naokiiwakami/cv-depot/doc/schematic-0.png

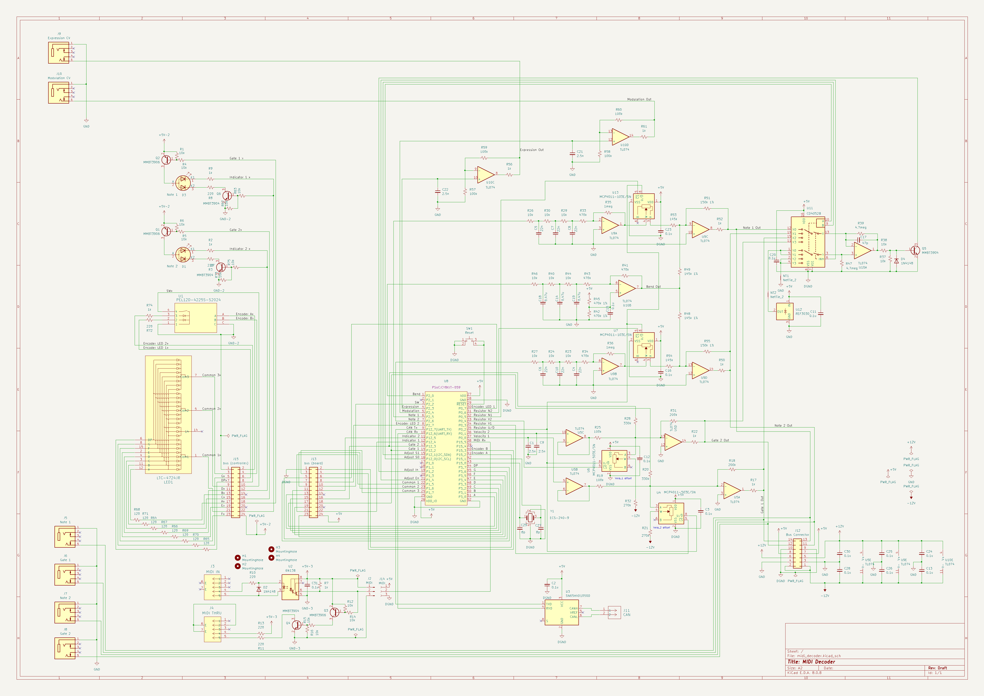
doc/schematic-0.png
