naokiiwakami/cv-depot/doc/schematic-1.png

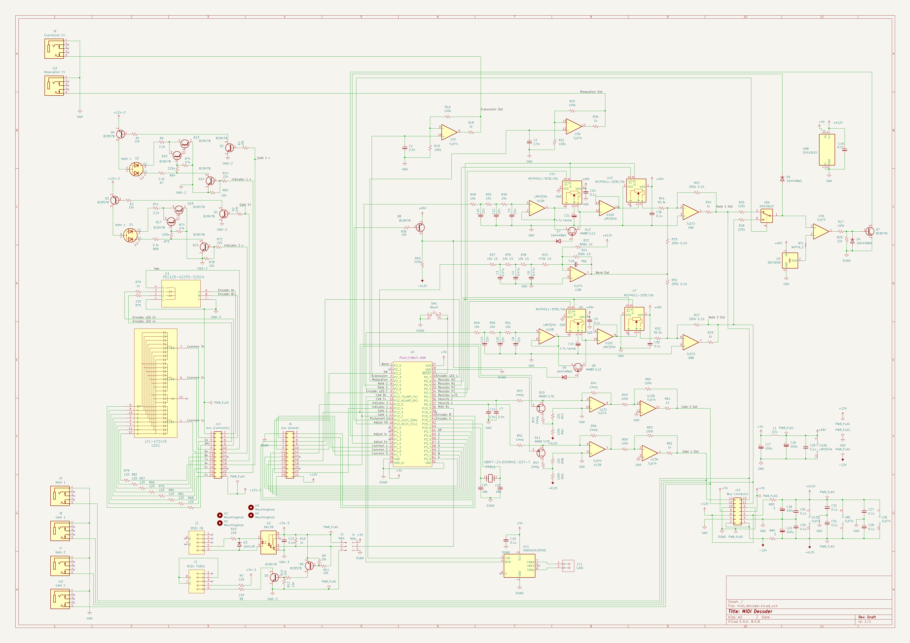
doc/schematic-1.png
