naokiiwakami/cv-depot/simulations/anti-alias-filter.asc

C1: cap; .0022µ
C2: cap; .0022µ
C3: cap; 2.2µ
R1: res; 1Meg
R2: res; 420k
R3: res; 10k
R4: res; 10k
R5: res; 70
R6: res; 49.03k
U1: TL072
V1: voltage; 12
V2: voltage; 12
V3: voltage; PULSE(0 5 10m 1n 1n 3u 5u 2000)
Named nets: 0
.tran 100m
