naokiiwakami/cv-depot/simulations/pi-filter-for-power-supply.asc

C1: cap; 100µ
C2: cap; 100µ
L1: ind; 22µ; Rser=1.25
R1: res; 4.7k
V1: voltage; ""; AC 1 0
Named nets: 0
.ac dec 100 1 200k
