naokiiwakami/cv-depot/simulations/rc-filter-for-power-supply.asc

C2: cap; 100µ; Rser=27m
R1: res; 5
V1: voltage; ""; AC 1 0
Named nets: 0
.ac dec 100 1 20k
