naokiiwakami/cv-depot/kicad/cv-depot.kicad_pcb

## KiCad design kicad/cv-depot.kicad_pcb (2025-03-31)

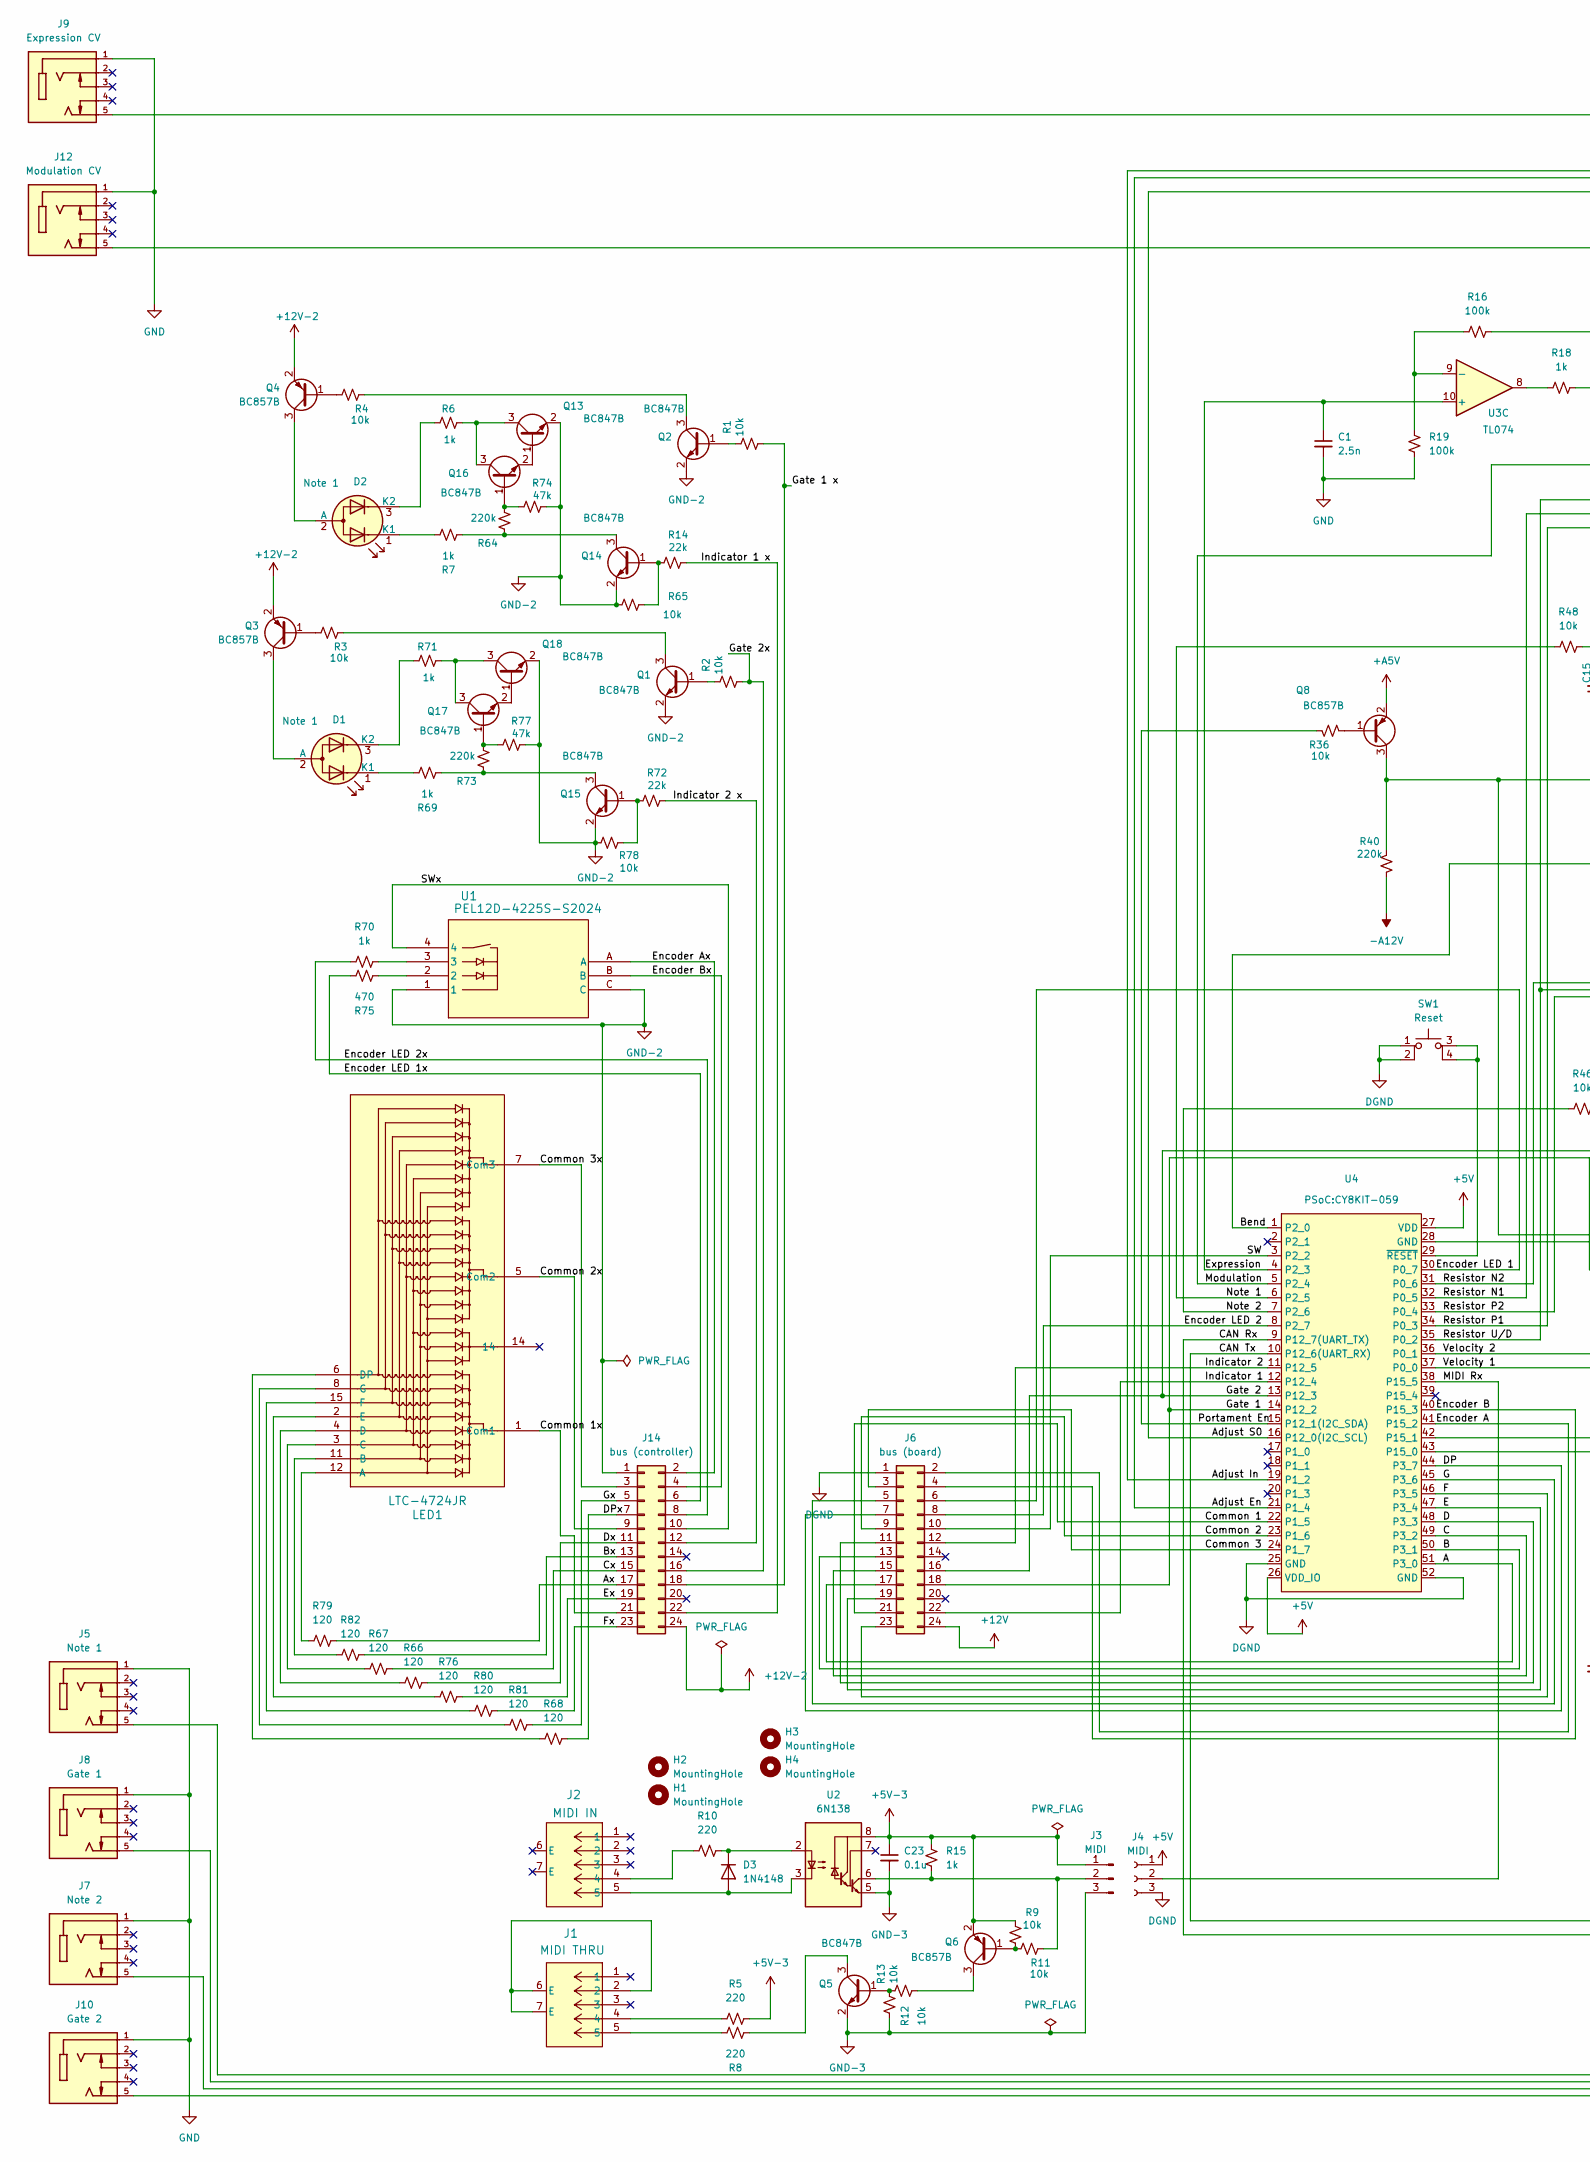
[picture p3: schematic cv-depot.kicad_sch, MIDI Decoder, part in row 1, column 1]

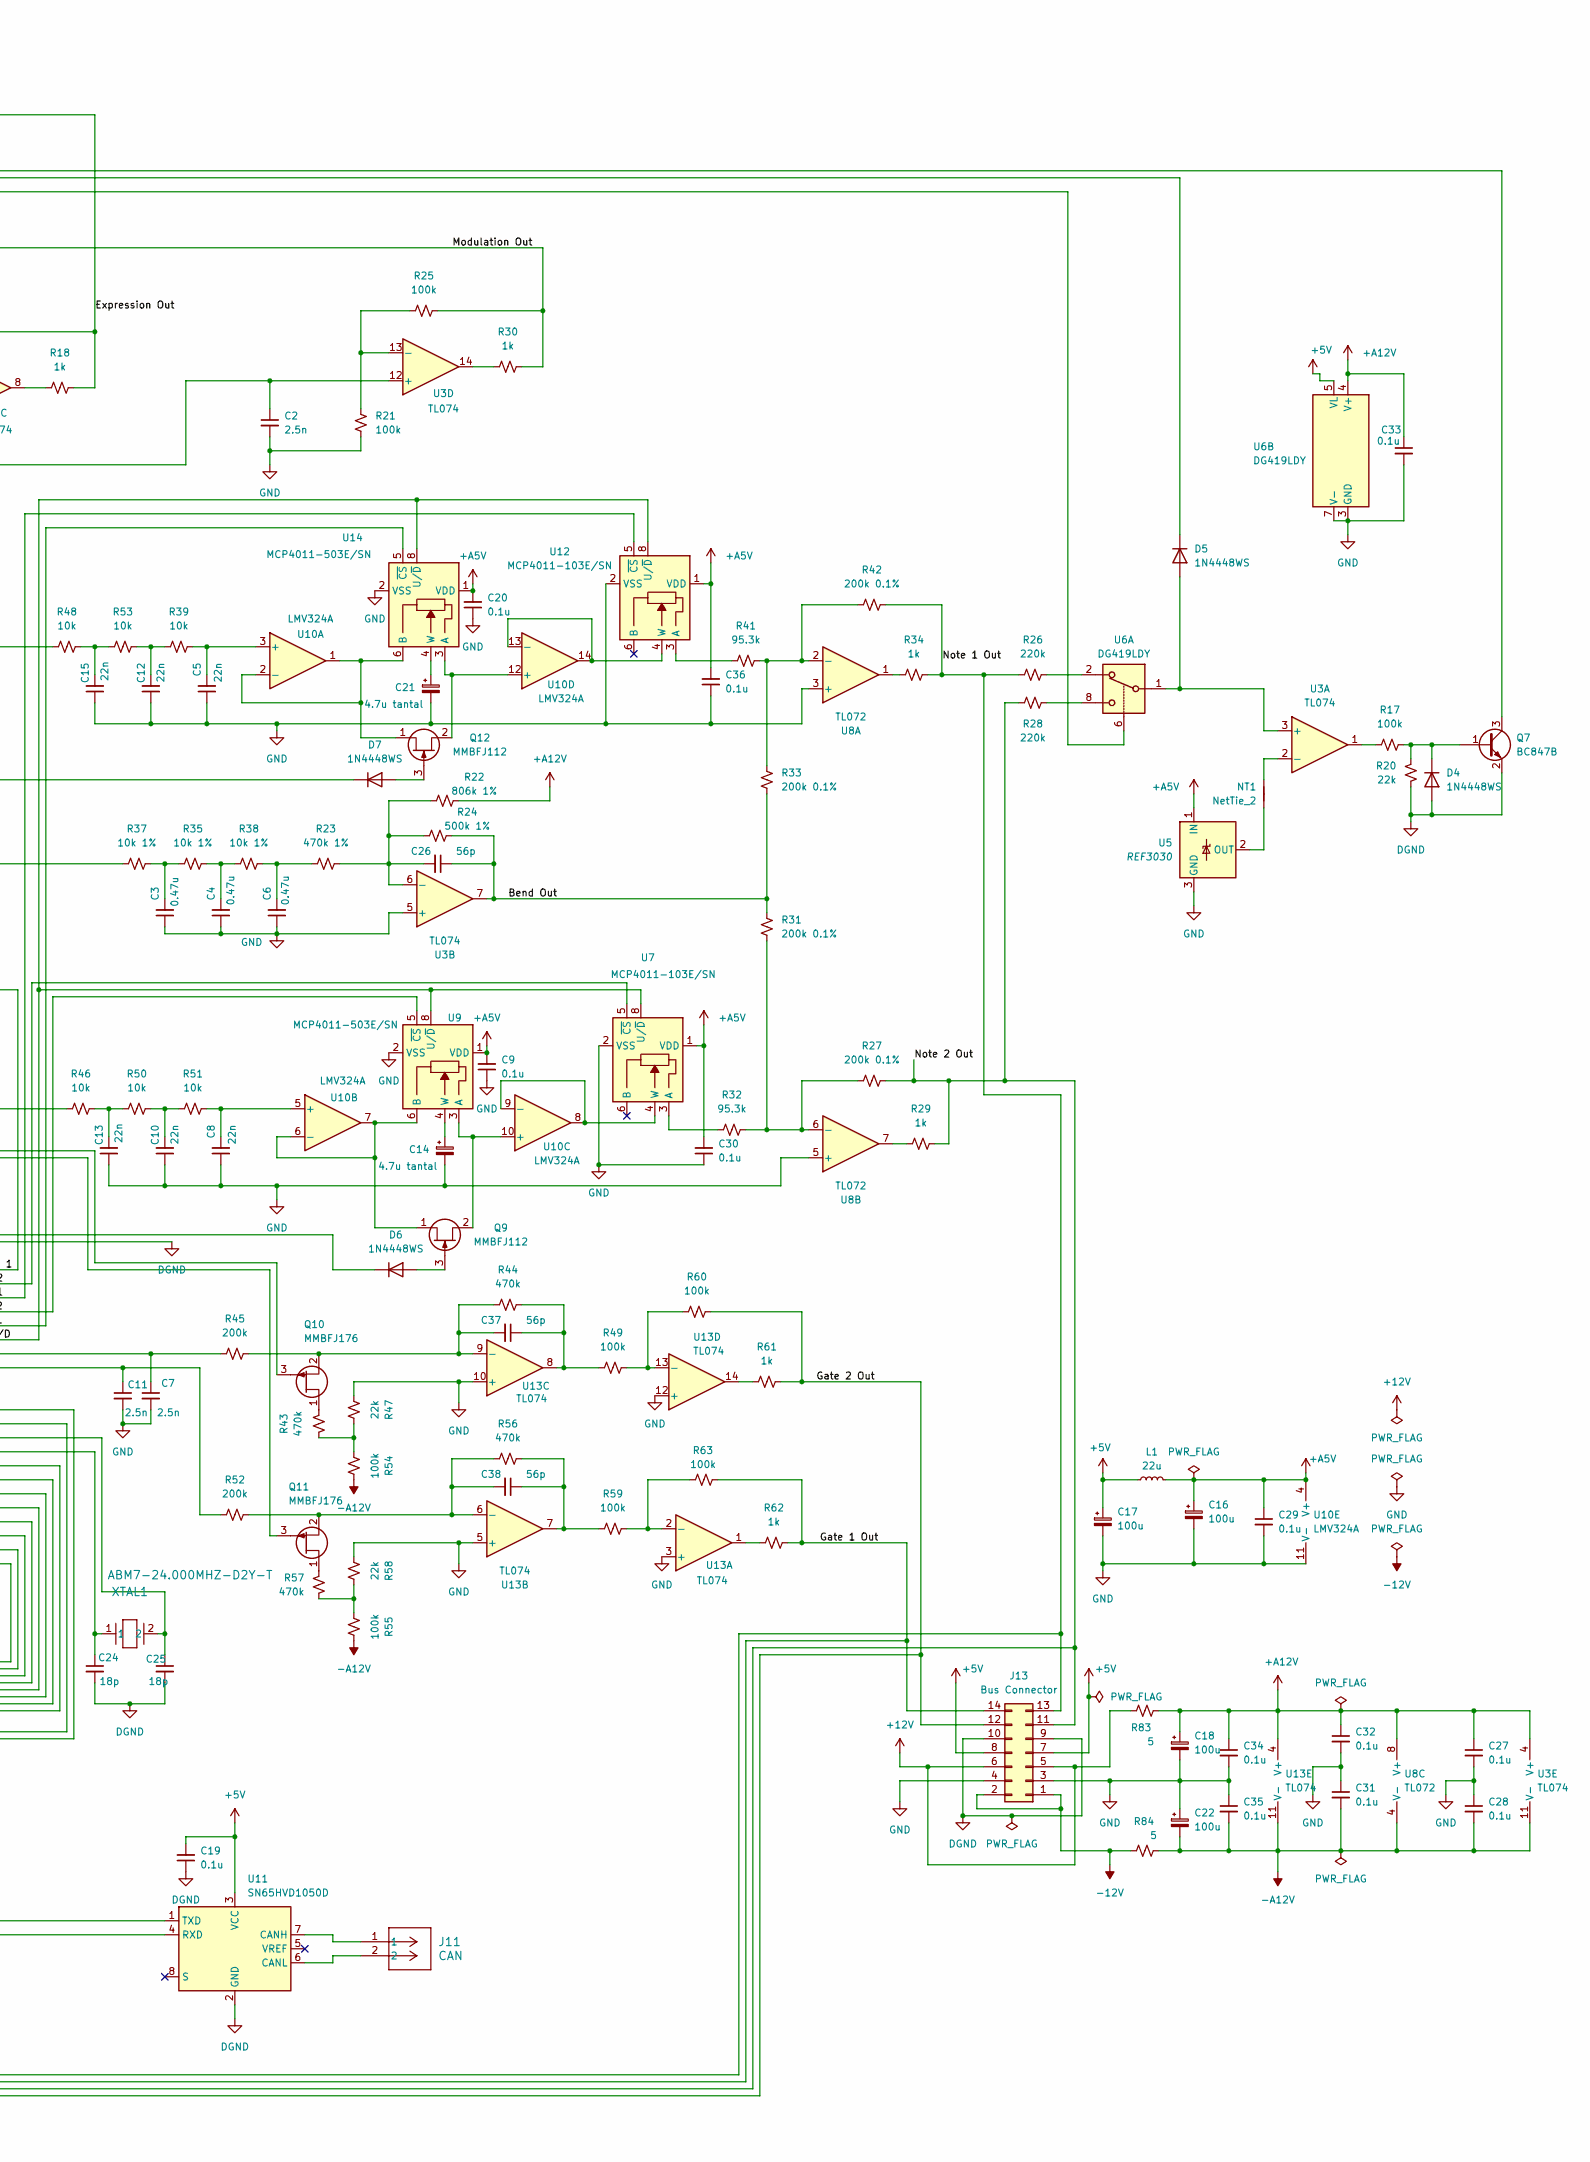
[picture p4: schematic cv-depot.kicad_sch, MIDI Decoder, part in row 1, column 2]

Parts:
C1, C2, C7, C11: 2.5n; C_0805_2012Metric_Pad1.18x1.45mm_HandSolder
C3, C4, C6: 0.47u; C_0805_2012Metric_Pad1.18x1.45mm_HandSolder
C5, C8, C10, C12, C13, C15: 22n; C_0805_2012Metric_Pad1.18x1.45mm_HandSolder
C9, C19, C20, C27, C28, C29, C30, C31, C32, C33, C34, C35, C36: 0.1u; C_0805_2012Metric_Pad1.18x1.45mm_HandSolder
C14, C21: 4.7u tantal; CP_EIA-3216-10_Kemet-I_Pad1.58x1.35mm_HandSolder
C16, C17: 100u; CP_Elec_5x5.3
C18, C22: 100u; CP_Radial_D6.3mm_P2.50mm
C23: 0.1u; R_0805_2012Metric_Pad1.20x1.40mm_HandSolder
C24, C25: 18p; C_0805_2012Metric_Pad1.18x1.45mm_HandSolder
C26, C37, C38: 56p; C_0805_2012Metric_Pad1.18x1.45mm_HandSolder
D1, D2: Note 1; LED_D5.0mm-3
D3: 1N4148; D_DO-35_SOD27_P7.62mm_Horizontal
D4, D5, D6, D7: 1N4448WS; D_SOD-323_HandSoldering
H1, H2, H3, H4: MountingHole; MountingHole_3.2mm_M3
J1: MIDI THRU; CONN5_SDS-50J_CUD
J2: MIDI IN; CONN5_SDS-50J_CUD
J3: MIDI; PinHeader_1x03_P2.54mm_Vertical
J4: MIDI; PinSocket_1x03_P2.54mm_Vertical
J5: Note 1; CONN_35RAPC4BH3_SWC; PARTREV J
J6: bus (board); PinHeader_2x12_P2.54mm_Vertical
J7: Note 2; CONN_35RAPC4BH3_SWC; PARTREV J
J8: Gate 1; CONN_35RAPC4BH3_SWC; PARTREV J
J9: Expression CV; CONN_35RAPC4BH3_SWC; PARTREV J
J10: Gate 2; CONN_35RAPC4BH3_SWC; PARTREV J
J11: CAN; CONN_A-6373-02A_MOL
J12: Modulation CV; CONN_35RAPC4BH3_SWC; PARTREV J
J13: Bus Connector; IDC-Header_2x07_P2.54mm_Vertical
J14: bus (controller); PinHeader_2x12_P2.54mm_Vertical
L1: 22u; L_0805_2012Metric_Pad1.05x1.20mm_HandSolder
LED1: LTC-4724JR; LTC-4724JR_LTO
NT1: NetTie_2; NetTie-2_SMD_Pad0.5mm
Q1, Q2, Q5, Q7, Q13, Q14, Q15, Q16, Q17, Q18: BC847B; SOT-23
Q3, Q4, Q6, Q8: BC857B; SOT-23
Q9, Q12: MMBFJ112; SOT-23
Q10, Q11: MMBFJ176; SOT-23
R1, R2, R3, R4, R9, R11, R12, R13, R36, R39, R46, R48, R50, R51, R53, R65, R78: 10k; D_0805_2012Metric_Pad1.15x1.40mm_HandSolder
R5, R8, R10: 220; R_0805_2012Metric_Pad1.20x1.40mm_HandSolder
R6, R7, R18, R29, R30, R34, R61, R62, R69, R70, R71: 1k; D_0805_2012Metric_Pad1.15x1.40mm_HandSolder
R14, R20, R72: 22k; D_0805_2012Metric_Pad1.15x1.40mm_HandSolder
R15: 1k; R_0805_2012Metric_Pad1.20x1.40mm_HandSolder
R16, R17, R19, R21, R25: 100k; D_0805_2012Metric_Pad1.15x1.40mm_HandSolder
R22: 806k 1%; D_0805_2012Metric_Pad1.15x1.40mm_HandSolder
R23: 470k 1%; D_0805_2012Metric_Pad1.15x1.40mm_HandSolder
R24: 500k 1%; D_0805_2012Metric_Pad1.15x1.40mm_HandSolder
R26, R28, R40, R64, R73: 220k; D_0805_2012Metric_Pad1.15x1.40mm_HandSolder
R27, R31, R33: 200k 0.1%; R_0805_2012Metric_Pad1.20x1.40mm_HandSolder
R32, R41: 95.3k; R_0805_2012Metric_Pad1.20x1.40mm_HandSolder
R35, R37, R38: 10k 1%; D_0805_2012Metric_Pad1.15x1.40mm_HandSolder
R42: 200k 0.1%; D_0805_2012Metric_Pad1.15x1.40mm_HandSolder
R43, R44, R56, R57: 470k; R_0805_2012Metric_Pad1.20x1.40mm_HandSolder
R45, R52: 200k; R_0805_2012Metric_Pad1.20x1.40mm_HandSolder
R47, R58: 22k; R_0805_2012Metric_Pad1.20x1.40mm_HandSolder
R49, R54, R55, R59, R60, R63: 100k; R_0805_2012Metric_Pad1.20x1.40mm_HandSolder
R66, R67, R68, R76, R79, R80, R81, R82: 120; R_0805_2012Metric_Pad1.20x1.40mm_HandSolder
R74, R77: 47k; D_0805_2012Metric_Pad1.15x1.40mm_HandSolder
R75: 470; D_0805_2012Metric_Pad1.15x1.40mm_HandSolder
R83, R84: 5; R_0805_2012Metric_Pad1.20x1.40mm_HandSolder
SW1: Reset; SW4_1825910-B_TEC
U1: PEL12D-4225S-S2024; TO_4225S-S2024
U2: 6N138; DIP-8_W7.62mm_LongPads
U3, U13: TL074; SOIC-14_3.9x8.7mm_P1.27mm
U4: CY8KIT-059
U5: REF3030; SOT-23
U6: DG419LDY; SOIC-8_3.9x4.9mm_P1.27mm
U7, U12: MCP4011-103E/SN; SOIC-8_3.9x4.9mm_P1.27mm
U8: TL072; SOIC-8_3.9x4.9mm_P1.27mm
U9, U14: MCP4011-503E/SN; SOIC-8_3.9x4.9mm_P1.27mm
U10: LMV324A; SOIC-14_3.9x8.7mm_P1.27mm
U11: SN65HVD1050D; SOIC-8_3.9x4.9mm_P1.27mm
XTAL1: ABM7-24.000MHZ-D2Y-T; XTAL_ABM7_ABR_handsoldering

Connections:
+5V: C17.1, C19.2, J4.1, J13.7, J13.8, L1.1, U4.26 (VDD_IO), U4.27 (VDD), U6.5 (VL), U11.3 (VCC)
+5V-3: C23.1, J3.1, Q6.2 (E), R5.2, R9.2, R15.2, U2.8 (VCC)
+12V: J6.24, J13.5, J13.6, R83.1
+12V-2: J14.24, Q3.2 (E), Q4.2 (E)
+A5V: C9.2, C16.1, C20.2, C29.1, C30.2, C36.2, L1.2, Q8.2 (E), U5.1 (IN), U7.1 (VDD), U9.1 (VDD), U10.4 (V+), U12.1 (VDD), U14.1 (VDD)
+A12V: C18.1, C27.1, C32.1, C33.1, C34.1, R22.2, R83.2, U3.4 (V+), U6.4 (V+), U8.8 (V+), U13.4 (V+)
-12V: J13.1, J13.2, R84.1
-A12V: C22.2, C28.2, C31.2, C35.2, R40.1, R54.2, R55.2, R84.2, U3.11 (V-), U8.4 (V-), U13.11 (V-)
/A: J6.17, U4.51 (P3_0)
/Adjust En: D5.1 (K), U4.21 (P1_4)
/Adjust In: Q7.3 (C), U4.19 (P1_2)
/Adjust S0: U4.16 (P12_0(I2C_SCL)), U6.6
/Ax: J14.17, R79.2
/B: J6.13, U4.50 (P3_1)
/Bend: R37.1, U4.1 (P2_0)
/Bend Out: C26.1, R24.2, R31.2, R33.1, U3.7
/Bx: J14.13, R82.2
/C: J6.15, U4.49 (P3_2)
/CAN Rx: U4.9 (P12_7(UART_TX)), U11.4 (RXD)
/CAN Tx: U4.10 (P12_6(UART_RX)), U11.1 (TXD)
/Common 1: J6.21, U4.22 (P1_5)
/Common 1x: J14.21, LED1.1 (Com1)
/Common 2: J6.9, U4.23 (P1_6)
/Common 2x: J14.9, LED1.5 (Com2)
/Common 3: J6.3, U4.24 (P1_7)
/Common 3x: J14.3, LED1.7 (Com3)
/Cx: J14.15, R67.2
/D: J6.11, U4.48 (P3_3)
/DP: J6.7, U4.44 (P3_7)
/DPx: J14.7, R68.2
/Dx: J14.11, R66.2
/E: J6.19, U4.47 (P3_4)
/Encoder A: J6.2, U4.41 (P15_2)
/Encoder Ax: J14.2, U1.A
/Encoder B: J6.4, U4.40 (P15_3)
/Encoder Bx: J14.4, U1.B
/Encoder LED 1: J6.6, U4.30 (P0_7)
/Encoder LED 1x: J14.6, R75.2
/Encoder LED 2: J6.8, U4.8 (P2_7)
/Encoder LED 2x: J14.8, R70.1
/Ex: J14.19, R76.2
/Expression: C1.1, U3.10 (+), U4.4 (P2_3)
/Expression Out: J9.5, R16.2, R18.2
/F: J6.23, U4.46 (P3_5)
/Fx: J14.23, R80.2
/G: J6.5, U4.45 (P3_6)
/Gate 1: J6.18, Q11.3 (G), U4.14 (P12_2)
/Gate 1 Out: J8.5, J13.14, R62.2, R63.2
/Gate 1 x: J14.18, R1.1
/Gate 2: J6.16, Q10.3 (G), U4.13 (P12_3)
/Gate 2 Out: J10.5, J13.12, R60.2, R61.2
/Gate 2x: J14.16, R2.1
/Gx: J14.5, R81.2
/Indicator 1: J6.22, U4.12 (P12_4)
/Indicator 1 x: J14.22, R14.1
/Indicator 2: J6.12, U4.11 (P12_5)
/Indicator 2 x: J14.12, R72.1
/MIDI Rx: J4.2, U4.38 (P15_5)
/Modulation: C2.1, U3.12 (+), U4.5 (P2_4)
/Modulation Out: J12.5, R25.2, R30.2
/Note 1: R48.1, U4.6 (P2_5)
/Note 1 Out: J5.5, J13.13, R26.1, R34.2, R42.2
/Note 2: R46.1, U4.7 (P2_6)
/Note 2 Out: J7.5, J13.11, R27.2, R28.2, R29.2
/Portament En: R36.2, U4.15 (P12_1(I2C_SDA))
/Resistor N1: U4.32 (P0_5), U12.5 (~CS)
/Resistor N2: U4.31 (P0_6), U7.5 (~CS)
/Resistor P1: U4.34 (P0_3), U14.5 (~CS)
/Resistor P2: U4.33 (P0_4), U9.5 (~CS)
/Resistor U/D: U4.35 (P0_2), U7.8 (U/~D), U9.8 (U/~D), U12.8 (U/~D), U14.8 (U/~D)
/SW: J6.10, U4.3 (P2_2)
/SWx: J14.10, U1.4
/Velocity 1: C11.1, R52.1, U4.37 (P0_0)
/Velocity 2: C7.1, R45.1, U4.36 (P0_1)
DGND: C19.1, C24.2, C25.2, D4.2 (A), J4.3, J6.1, J13.9, J13.10, Q7.2 (E), R20.1, SW1.1, SW1.2, U4.25 (GND), U4.28 (GND), U4.52 (GND), U11.2 (GND)
GND: C1.2, C2.2, C3.1, C4.1, C5.1, C6.1, C7.2, C8.1, C9.1, C10.1, C11.2, C12.1, C13.1, C14.2, C15.1, C16.2, C17.2, C18.2, C20.1, C21.2, C22.1, C27.2, C28.1, C29.2, C30.1, C31.1, C32.2, C33.2, C34.2, C35.1, C36.1, J5.1, J7.1, J8.1, J9.1, J10.1, J12.1, J13.3, J13.4, R19.1, R21.1, R47.1, R58.1, U3.5 (+), U5.3 (GND), U6.3 (GND), U6.7 (V-), U7.2 (VSS), U8.3 (+), U8.5 (+), U9.2 (VSS), U10.11 (V-), U12.2 (VSS), U13.3 (+), U13.5 (+), U13.10 (+), U13.12 (+), U14.2 (VSS)
GND-2: J14.1, Q1.2 (E), Q2.2 (E), Q13.2 (E), Q14.2 (E), Q15.2 (E), Q18.2 (E), R65.2, R74.2, R77.2, R78.2, U1.1, U1.C
GND-3: C23.2, J3.3, Q5.2 (E), R12.2, U2.5 (GND)
unnamed: C3.2, R35.1, R37.2
unnamed: C4.2, R35.2, R38.1
unnamed: C6.2, R23.1, R38.2
unnamed: C10.2, R50.2, R51.1
unnamed: C12.2, R39.1, R53.2
unnamed: C13.2, R46.2, R50.1
unnamed: C15.2, R48.2, R53.1
unnamed: C37.1, R44.2, R49.1, U13.8
unnamed: C38.1, R56.2, R59.1, U13.7
unnamed: D1.2 (A), Q3.3 (C)
unnamed: D1.1 (K1), R69.2
unnamed: D1.3 (K2), R71.1
unnamed: D2.2 (A), Q4.3 (C)
unnamed: D2.1 (K1), R7.2
unnamed: D2.3 (K2), R6.1
unnamed: D3.2 (A), J2.5, U2.3 (C2)
unnamed: D3.1 (K), R10.1, U2.2 (C1)
unnamed: D4.1 (K), Q7.1 (B), R17.2, R20.2
unnamed: D5.2 (A), U3.3 (+), U6.1
unnamed: D6.2 (A), Q9.3 (G)
unnamed: D6.1 (K), D7.1 (K), Q8.3 (C), R40.2
unnamed: D7.2 (A), Q12.3 (G)
unnamed: J1.2, J1.6 (E), J1.7 (E)
unnamed: J1.4, R5.1
unnamed: J1.5, R8.2
unnamed: J2.4, R10.2
unnamed: J3.2, R11.2, R15.1, U2.6 (VO2)
unnamed: LED1.12 (A), R79.1
unnamed: LED1.11 (B), R82.1
unnamed: LED1.3 (C), R67.1
unnamed: LED1.4 (D), R66.1
unnamed: LED1.6 (DP), R68.1
unnamed: LED1.2 (E), R76.1
unnamed: LED1.15 (F), R80.1
unnamed: LED1.8 (G), R81.1
unnamed: Q1.1 (B), R2.2
unnamed: Q1.3 (C), R3.2
unnamed: Q2.1 (B), R1.2
unnamed: Q2.3 (C), R4.2
unnamed: Q3.1 (B), R3.1
unnamed: Q4.1 (B), R4.1
unnamed: Q5.1 (B), R12.1, R13.2
unnamed: Q5.3 (C), R8.1
unnamed: Q6.1 (B), R9.1, R11.1
unnamed: Q6.3 (C), R13.1
unnamed: Q8.1 (B), R36.1
unnamed: Q9.1 (D), U9.6 (B), U10.6 (-), U10.7
unnamed: Q9.2 (S), U9.3 (A), U10.10 (+)
unnamed: Q10.1 (D), R43.1
unnamed: C37.2, Q10.2 (S), R44.1, R45.2, U13.9 (-)
unnamed: Q11.1 (D), R57.1
unnamed: C38.2, Q11.2 (S), R52.2, R56.1, U13.6 (-)
unnamed: Q12.1 (D), U10.1, U10.2 (-), U14.6 (B)
unnamed: Q12.2 (S), U10.12 (+), U14.3 (A)
unnamed: Q13.1 (B), Q16.2 (E)
unnamed: Q13.3 (C), Q16.3 (C), R6.2
unnamed: Q14.1 (B), R14.2, R65.1
unnamed: Q14.3 (C), R7.1, R64.2
unnamed: Q15.1 (B), R72.2, R78.1
unnamed: Q15.3 (C), R69.1, R73.2
unnamed: Q16.1 (B), R64.1, R74.1
unnamed: Q17.1 (B), R73.1, R77.1
unnamed: Q17.3 (C), Q18.3 (C), R71.2
unnamed: Q17.2 (E), Q18.1 (B)
unnamed: R17.1, U3.1
unnamed: R18.1, U3.8
unnamed: R26.2, U6.2
unnamed: R28.1, U6.8
unnamed: R29.1, U8.7
unnamed: R30.1, U3.14
unnamed: R34.1, U8.1
unnamed: R43.2, R47.2, R54.1
unnamed: R55.1, R57.2, R58.2
unnamed: R61.1, U13.14
unnamed: R62.1, U13.1
unnamed: R70.2, U1.3
unnamed: R75.1, U1.2
unnamed: NT1.2, U3.2 (-)
unnamed: C26.2, R22.1, R23.2, R24.1, U3.6 (-)
unnamed: R16.1, R19.2, U3.9 (-)
unnamed: R21.2, R25.1, U3.13 (-)
unnamed: C24.1, U4.43 (P15_0), XTAL1.1
unnamed: C25.1, U4.42 (P15_1), XTAL1.2
unnamed: SW1.3, SW1.4, U4.29 (~RESET)
unnamed: NT1.1, U5.2 (OUT)
unnamed: R32.1, U7.3 (A)
unnamed: R33.2, R41.2, R42.1, U8.2 (-)
unnamed: R27.1, R31.1, R32.2, U8.6 (-)
unnamed: C14.1, U9.4 (W)
unnamed: C5.2, R39.2, U10.3 (+)
unnamed: C8.2, R51.2, U10.5 (+)
unnamed: U7.4 (W), U10.8, U10.9 (-)
unnamed: U10.13 (-), U10.14, U12.4 (W)
unnamed: J11.1, U11.7 (CANH)
unnamed: J11.2, U11.6 (CANL)
unnamed: R41.1, U12.3 (A)
unnamed: R59.2, R63.1, U13.2 (-)
unnamed: R49.2, R60.1, U13.13 (-)
unnamed: C21.1, U14.4 (W)

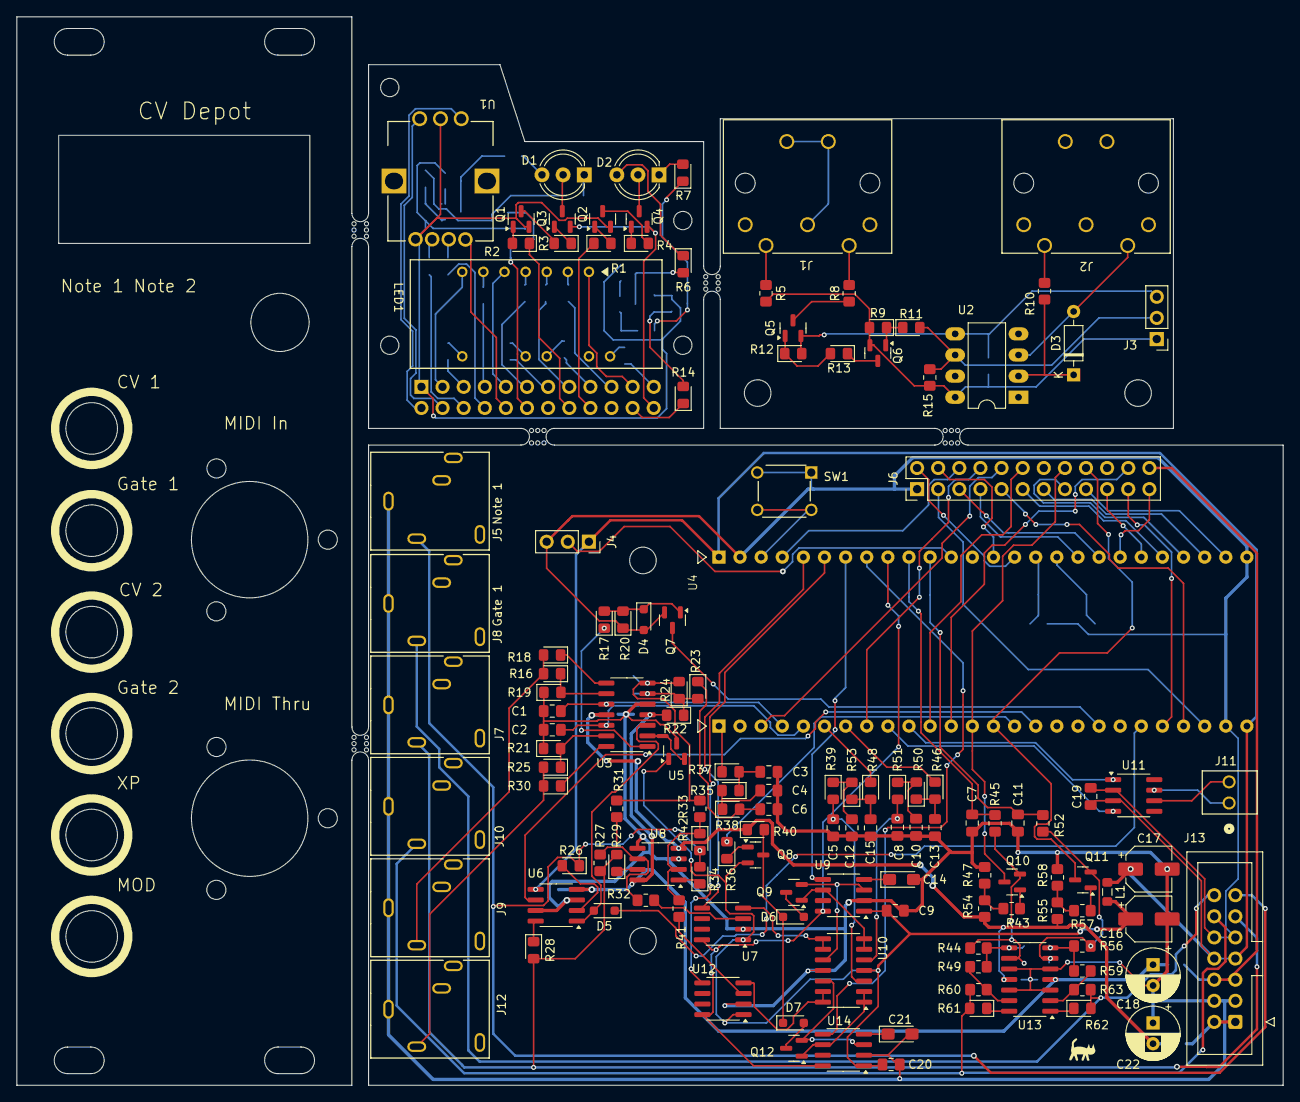
[picture p5: board cv-depot.kicad_pcb from above]

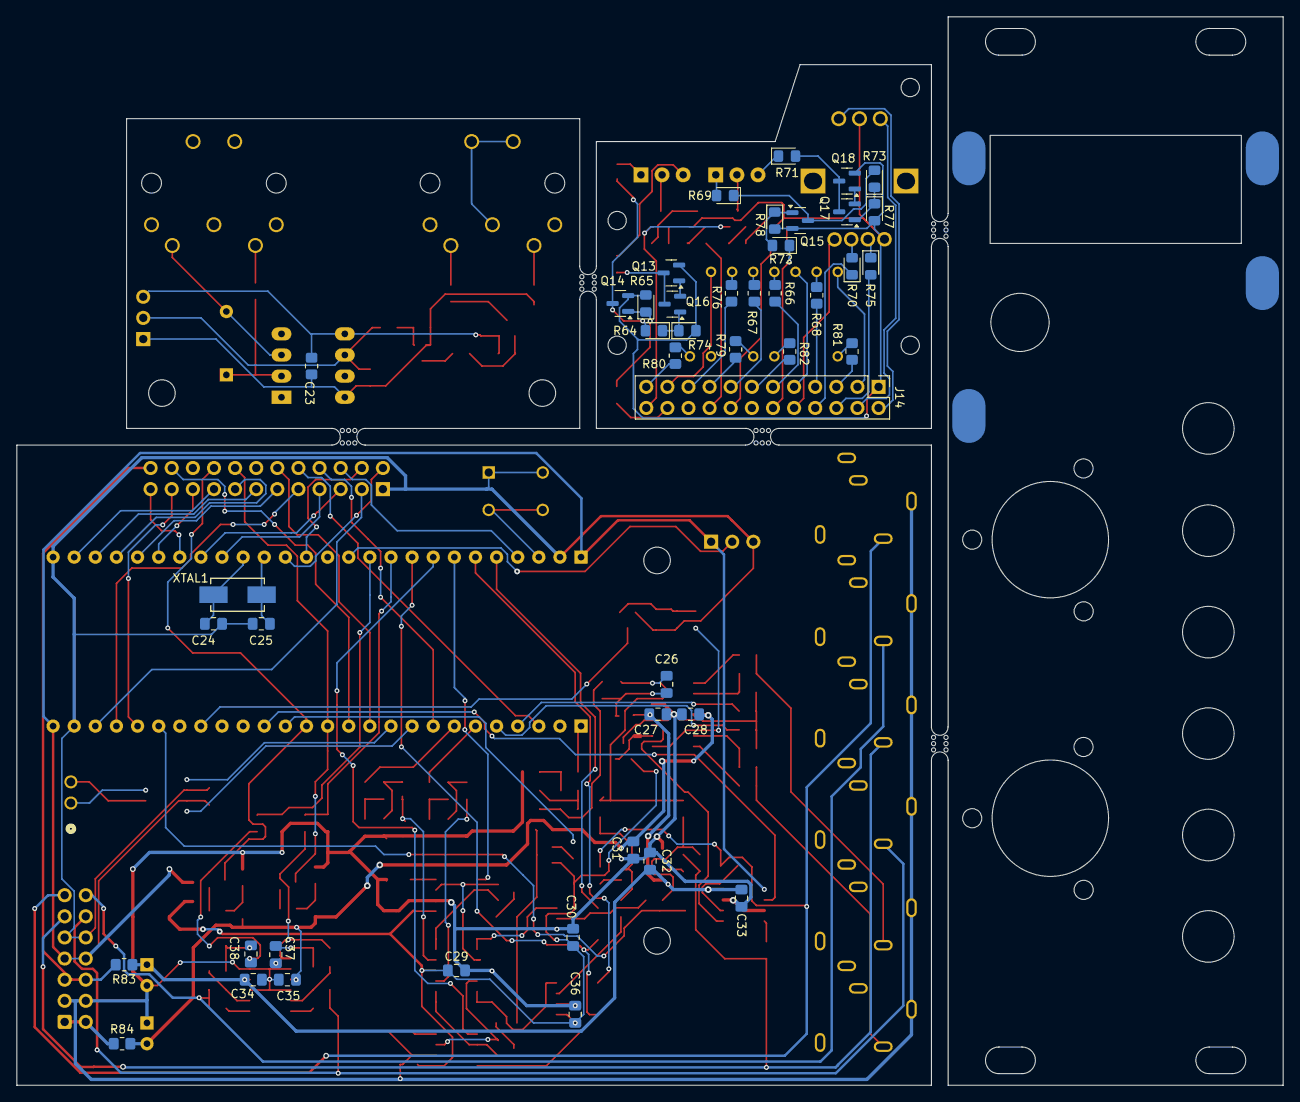
[picture p6: board cv-depot.kicad_pcb from below]

Board: 2 copper layers, 152.3 x 128.5 mm, 205 parts (49 on the bottom side), 177 nets.

Other parts of the board:
MB1: MB1; mouse-bite-2mm-slot
MB2: MB2; mouse-bite-2mm-slot
MB3: mb3; mouse-bite-2mm-slot
MB4: MB4; mouse-bite-2mm-slot
MB5: MB5; mouse-bite-2mm-slot
P1, P2: LED Window 5mm
P3: LTC-4724JR_LTO
P4: PEL12D
P5, P6, P8, P9, P10, P11: 3.5mm single channel
P7, P12: DIN 5 pin
P13, P14, P15, P16: Spacer 2M without hole
