naokiiwakami/cv-depot/PSoC/cv-depot.cydsn/settings.h

/* ========================================
 *
 * Copyright YOUR COMPANY, THE YEAR
 * All Rights Reserved
 * UNPUBLISHED, LICENSED SOFTWARE.
 *
 * CONFIDENTIAL AND PROPRIETARY INFORMATION
 * WHICH IS THE PROPERTY OF your company.
 *
 * ========================================
*/

#pragma once

extern void HandleSettingModes();
extern void HandleSwitchEvent();

/* [] END OF FILE */
