naokiiwakami/cv-depot/(commit log)

2025-02-04 Schematics and board initial commit
    [midi_decoder.kicad_pcb, midi_decoder.kicad_sch]
2025-02-14 revision 1
    [midi_decoder.kicad_pcb, midi_decoder.kicad_sch, supply_current.xlsx]
2025-02-14 renamed KiCad files
    [midi_decoder.kicad_pcb, midi_decoder.kicad_sch]
2025-02-20 renamed the project again
    [cv-depot.csv, cv-depot.kicad_pcb, cv-depot.kicad_sch]
2025-02-20 tweaked the PCB design
    [cv-depot.kicad_pcb]
2025-02-23 put all necessary components to shopping carts
    [cv-depot.csv]
2025-03-31 done with initial hardware check except voltage outputs
    [cv-depot-B_Cu.gbl, cv-depot-B_Mask.gbs, cv-depot-B_Paste.gbp, cv-depot-B_Silkscreen.gbo, cv-depot-Edge_Cuts.gm1, cv-depot-F_Cu.gtl, cv-depot-F_Mask.gts, cv-depot-F_Paste.gtp]
2025-04-02 added digital pot controller, verified in debugger (not yet in full speed)
    [cv-depot.kicad_sch]
2025-04-03 add calibration mode, wip
2025-04-05 fixed issues in pot control
    [main.c, pot.c, pot.h, pot_change.c, pot_change.h]
2025-04-06 CV range calibration, wip
2025-04-06 CV range calibration, wip3
2025-04-06 CV range calibration, done
2025-04-21 Modified the value of the resistor for the green LED
    [cv-depot.kicad_sch]
2025-04-26 fixed issue in handling negative menu index
    [main.c, main.h, settings.c]
2025-04-27 improve calibration performance
2025-05-02 Changed gate voltage ranges
2025-08-23 Improve stability of CAN communication
    [analog3.c, analog3.h, hardware.c, hardware.h, key_assigner.c, main.c]
2025-11-27 Bugfix in the key assigner
    [key_assigner.c]
2025-11-27 Add support for pitch bend
